tophee/FTXcontrol-Shield/images/RDKR_board_drawing.png

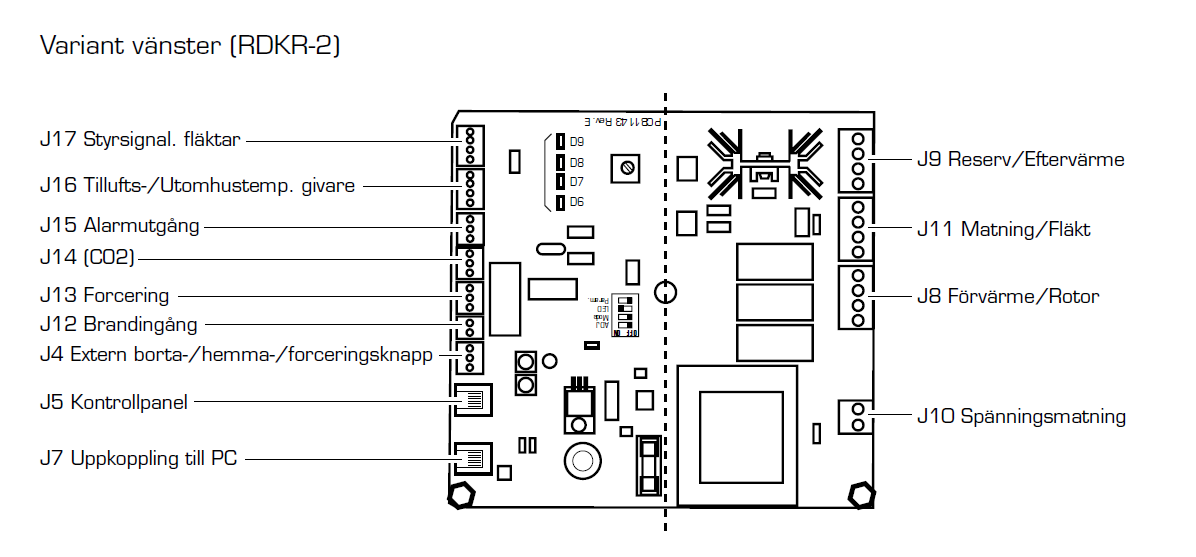
images/RDKR_board_drawing.png
