tophee/FTXcontrol-Shield/(commit log)

2020-10-04 More robust ventstate reading, switched to influxdb format
2020-10-11 added constant numerr
    not all errors were being reported
    [FTXcontrol-shield.ino]
